eddimull/slide-distance-display/hardware/slidepod-schematic.pdf

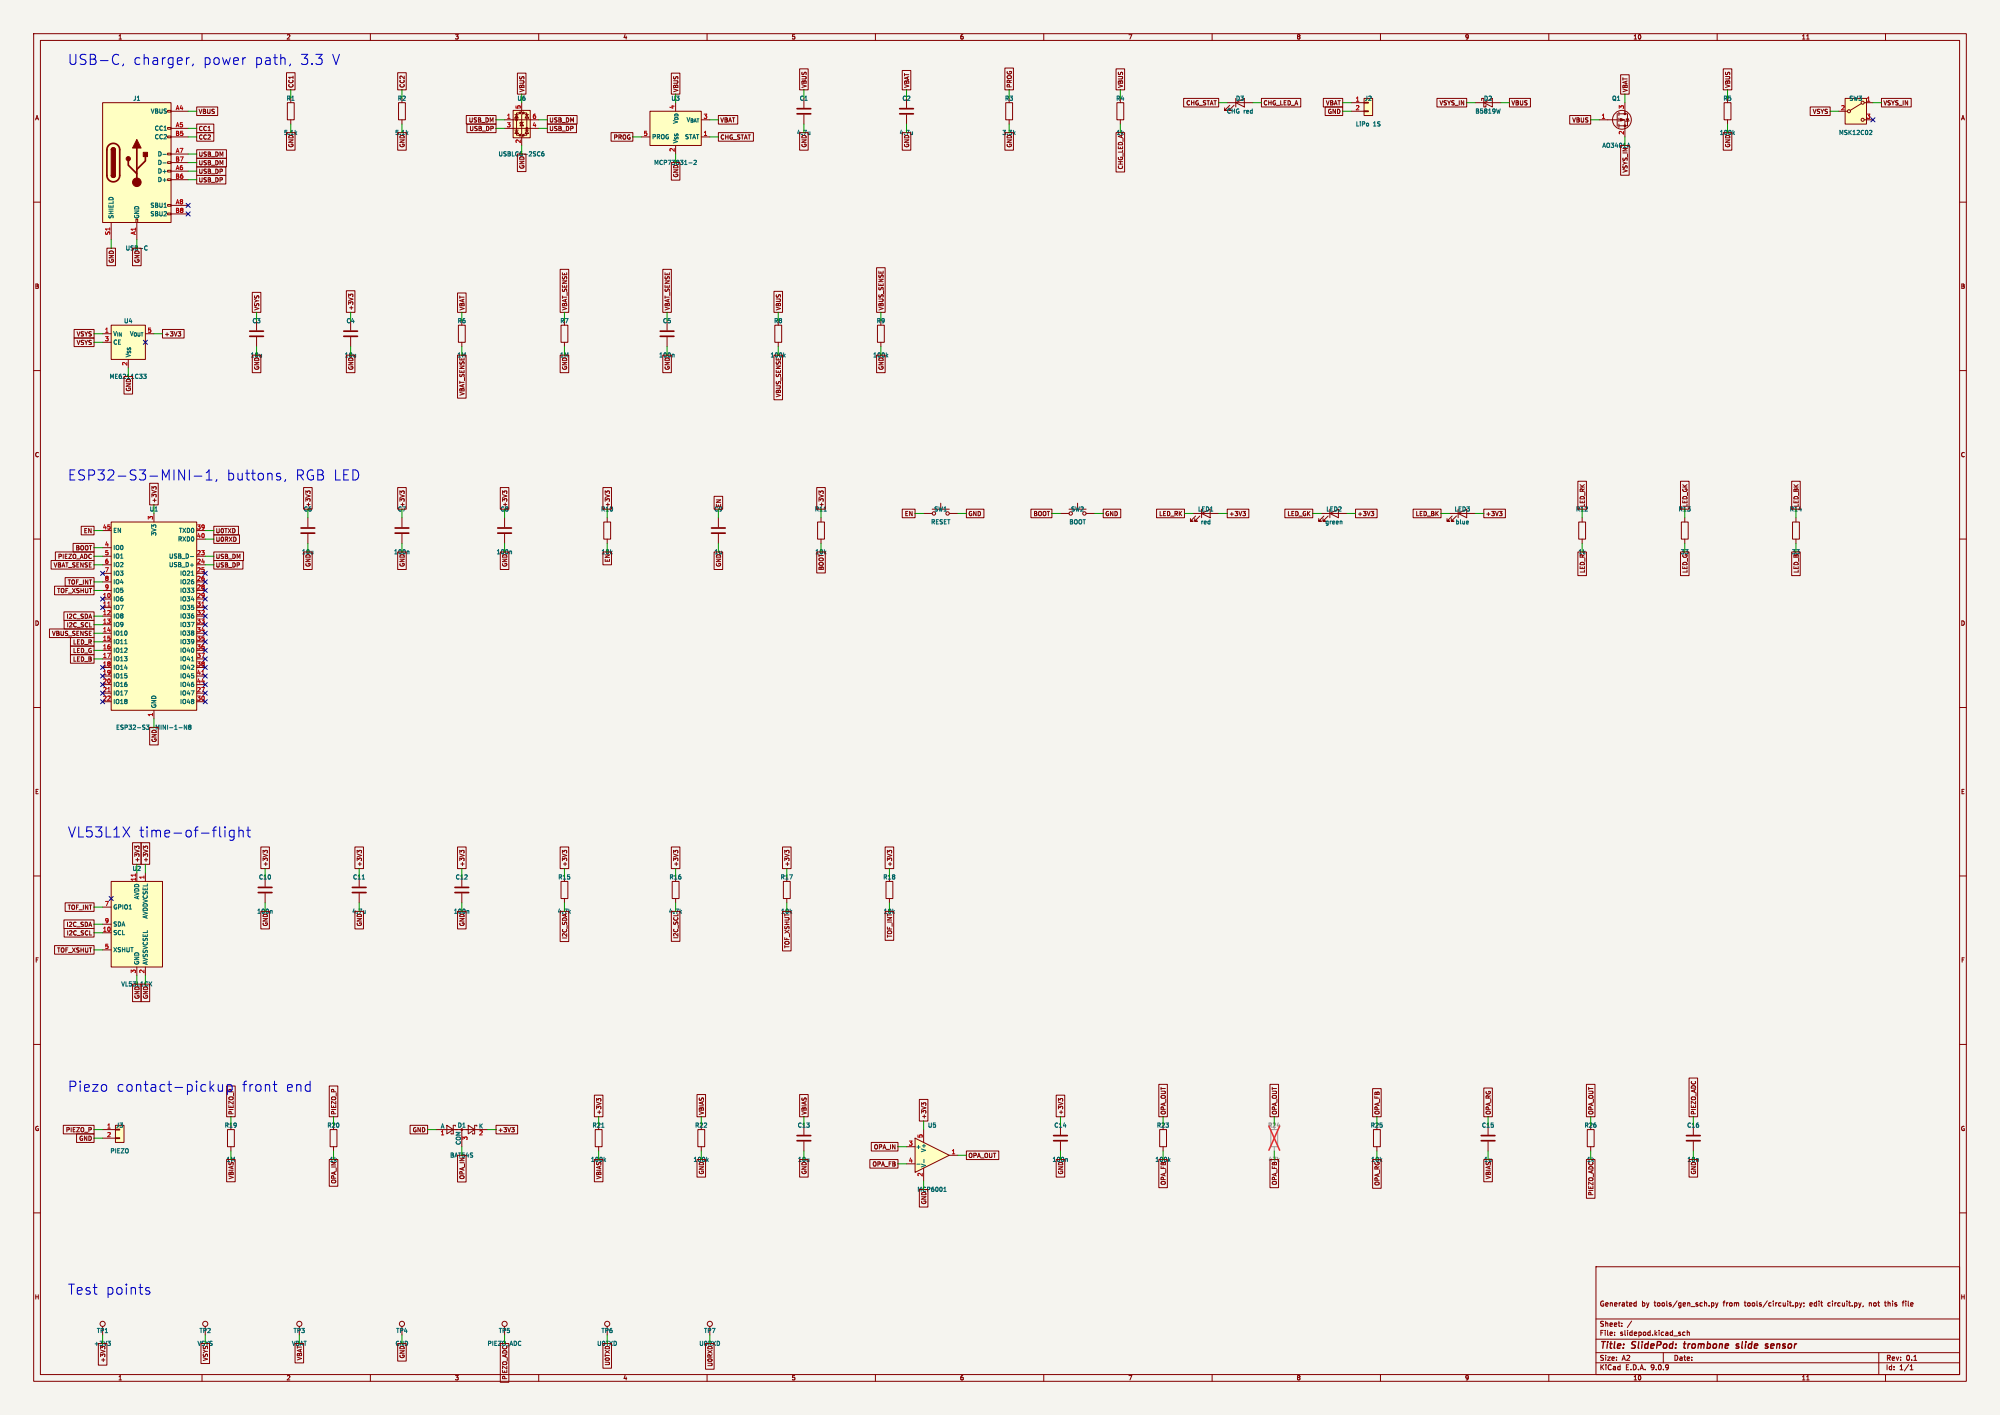
[picture p1: page 1]

USB-C, charger, power path, 3.3 V
