eddimull/slide-distance-display/hardware/slidepod.kicad_pcb

## KiCad design hardware/slidepod.kicad_pcb (2026-11-07)

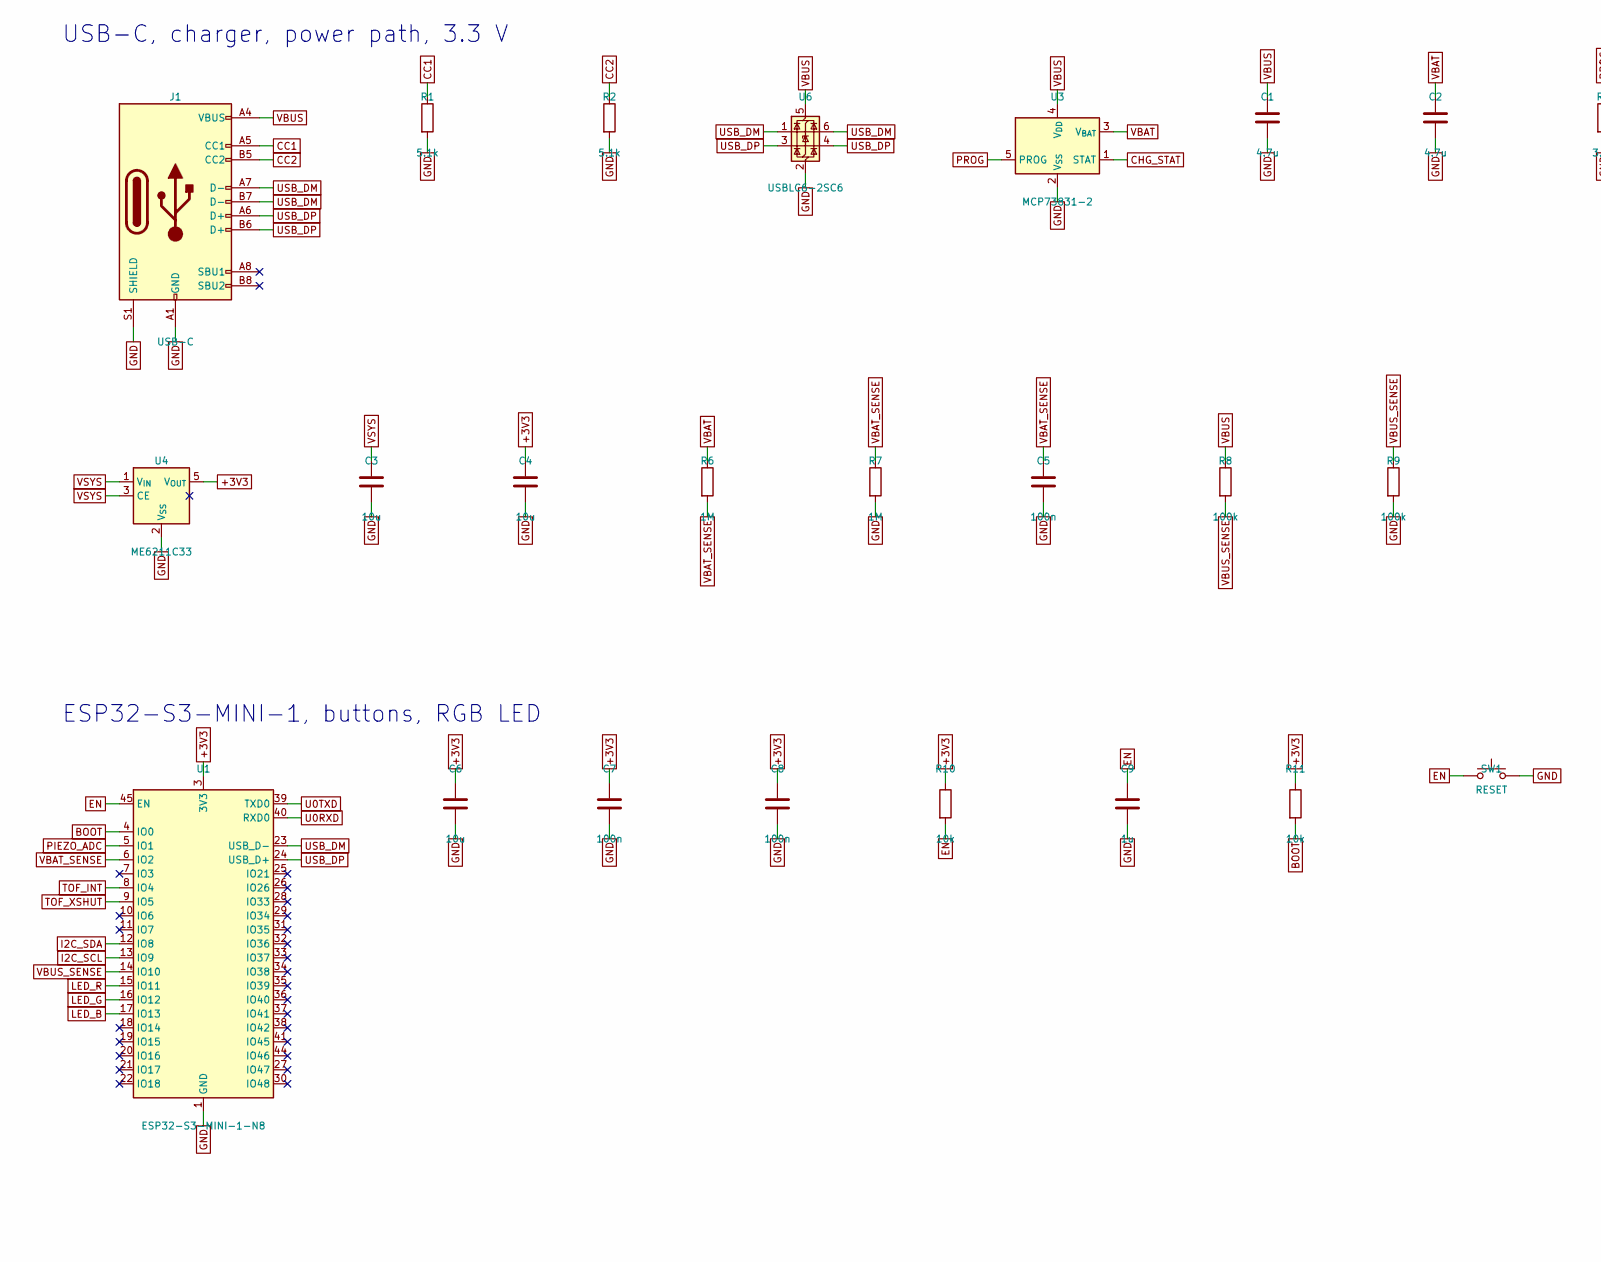
[picture p2: schematic slidepod.kicad_sch, SlidePod: trombone slide sensor, part in row 1, column 1]

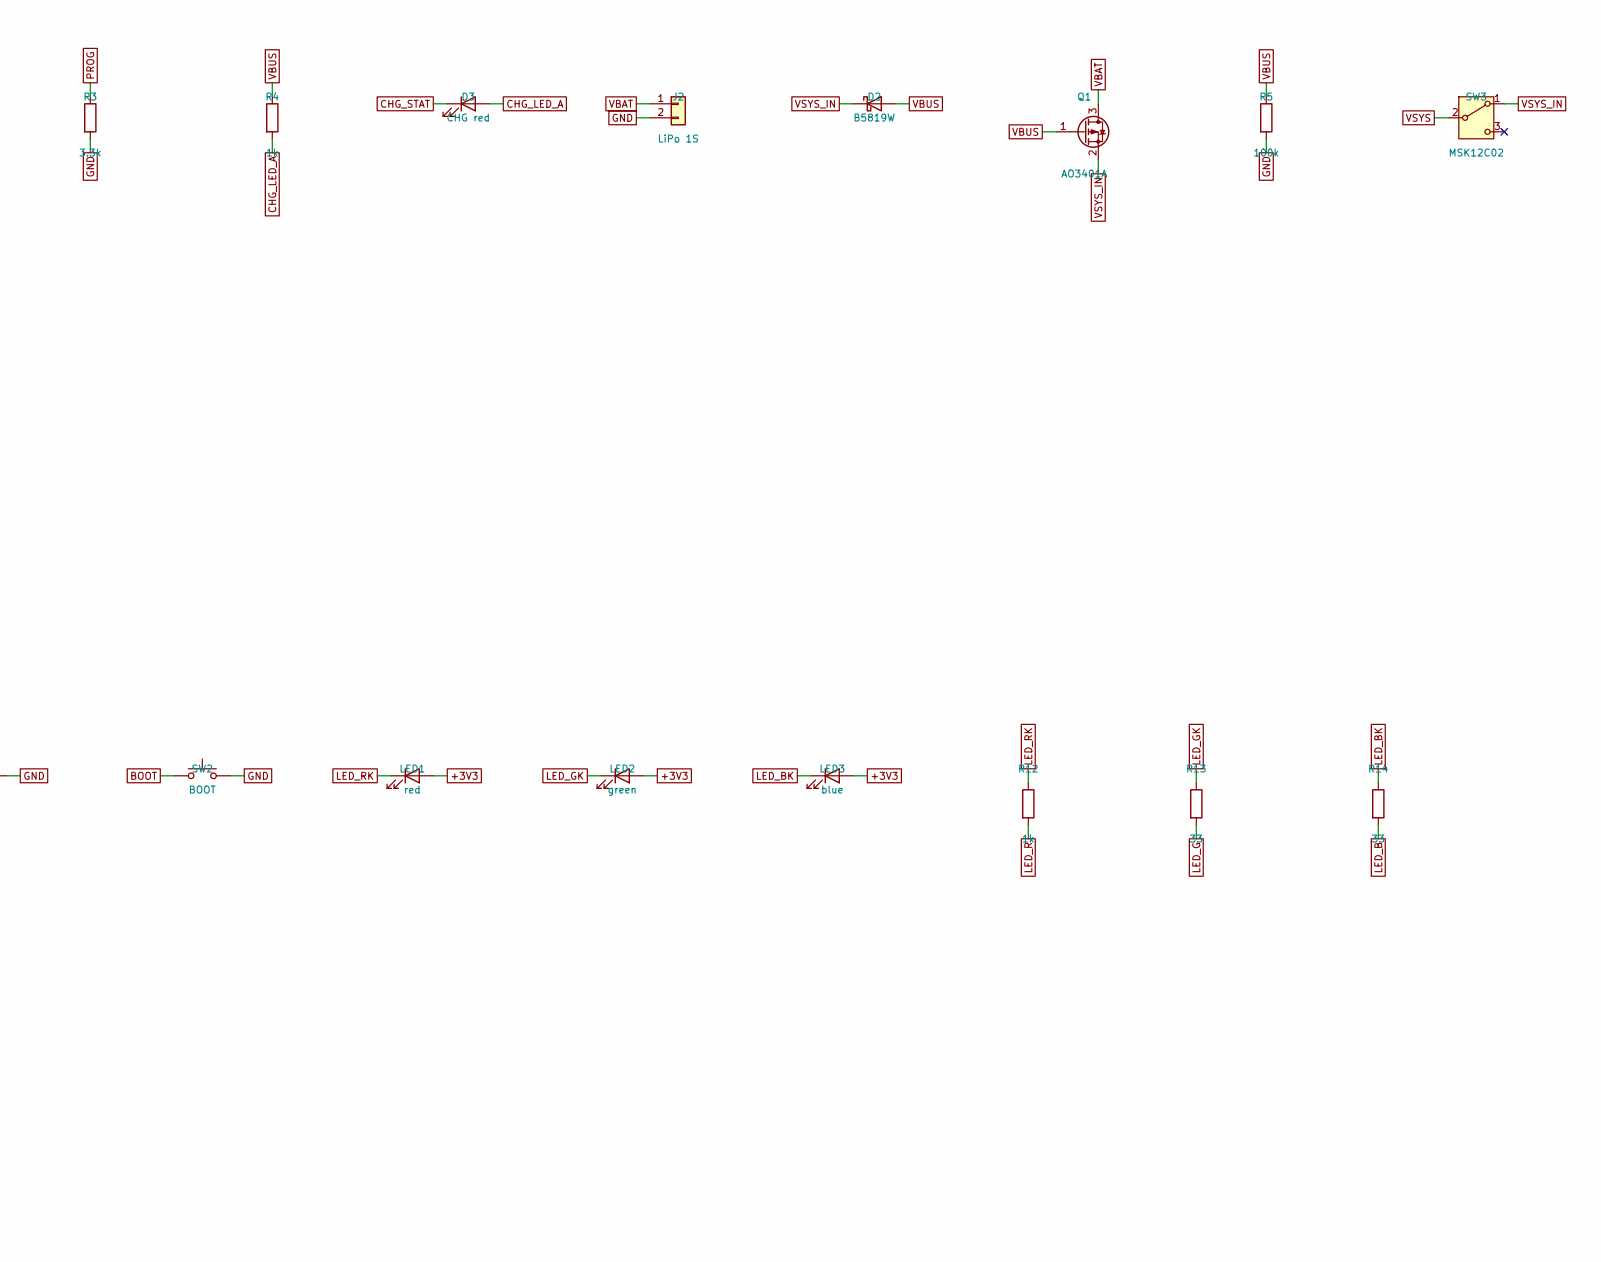
[picture p3: schematic slidepod.kicad_sch, SlidePod: trombone slide sensor, part in row 1, column 2]

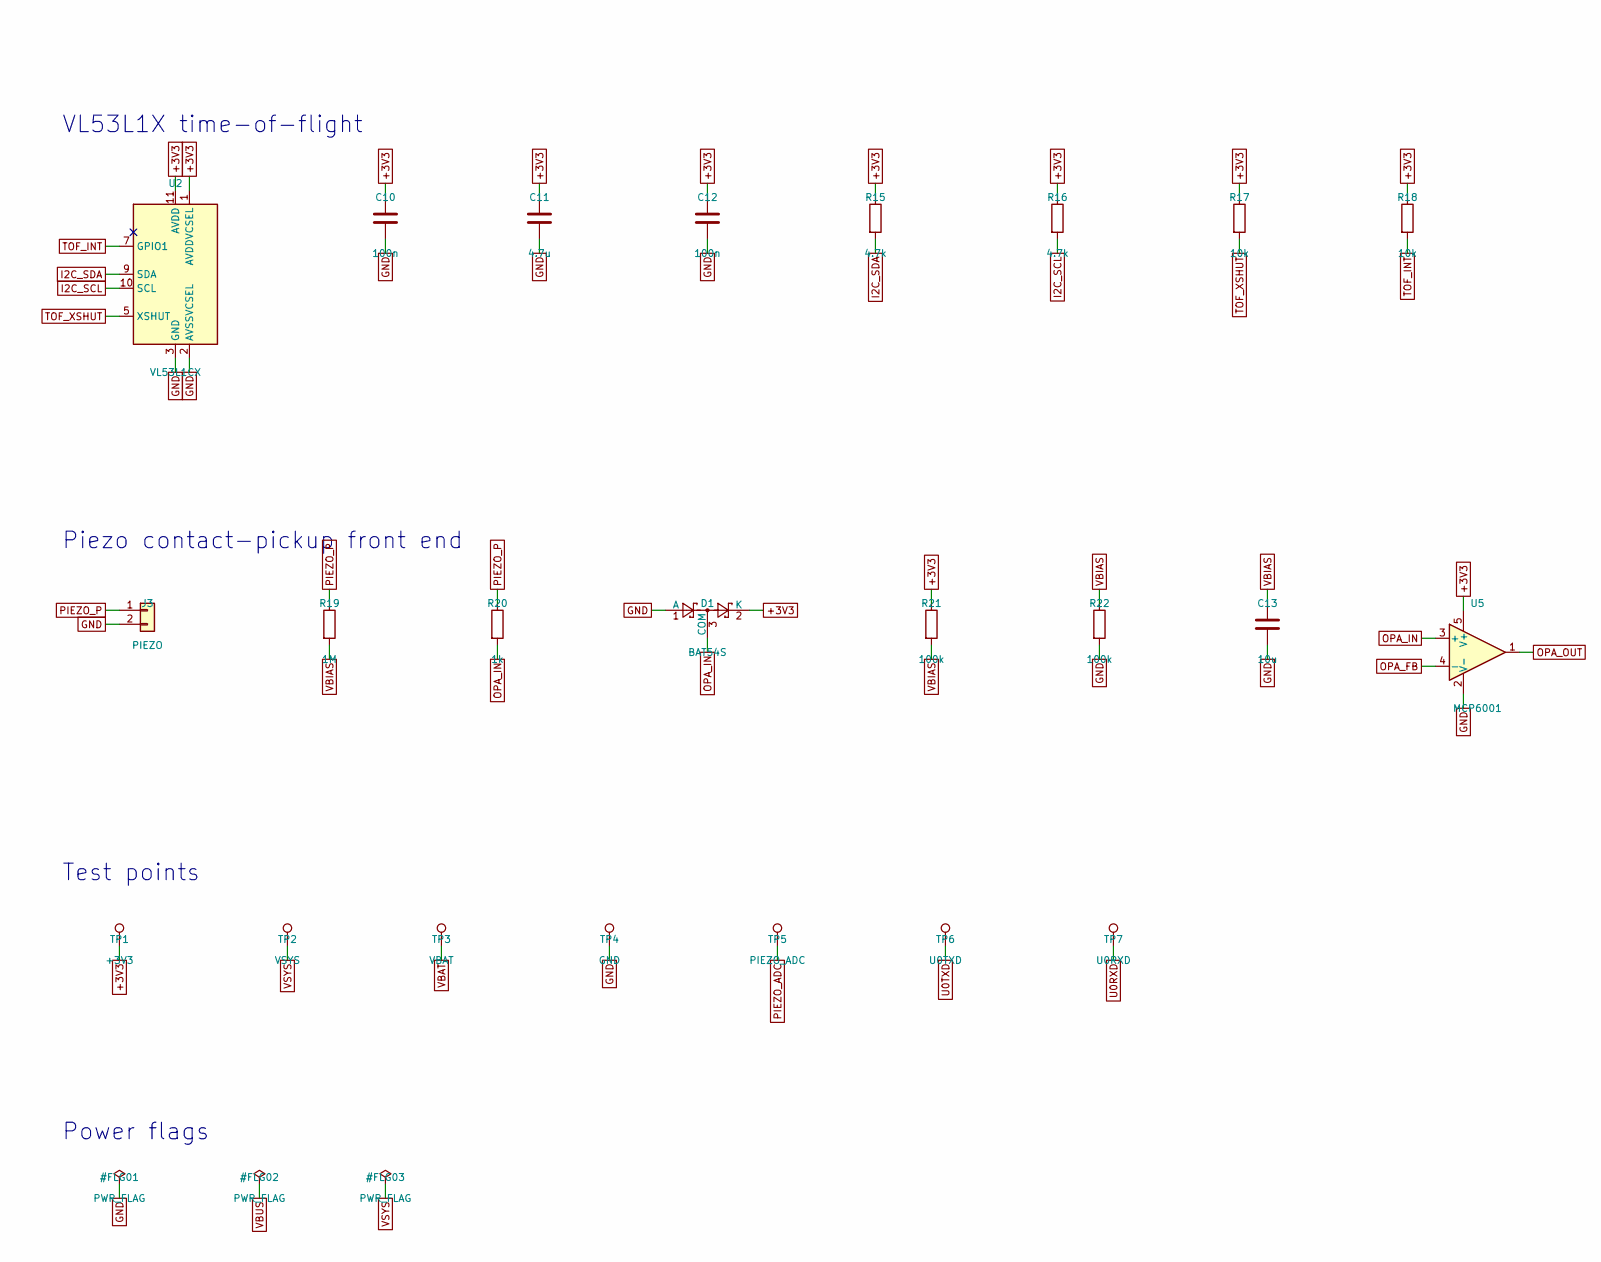
[picture p4: schematic slidepod.kicad_sch, SlidePod: trombone slide sensor, part in row 2, column 1]

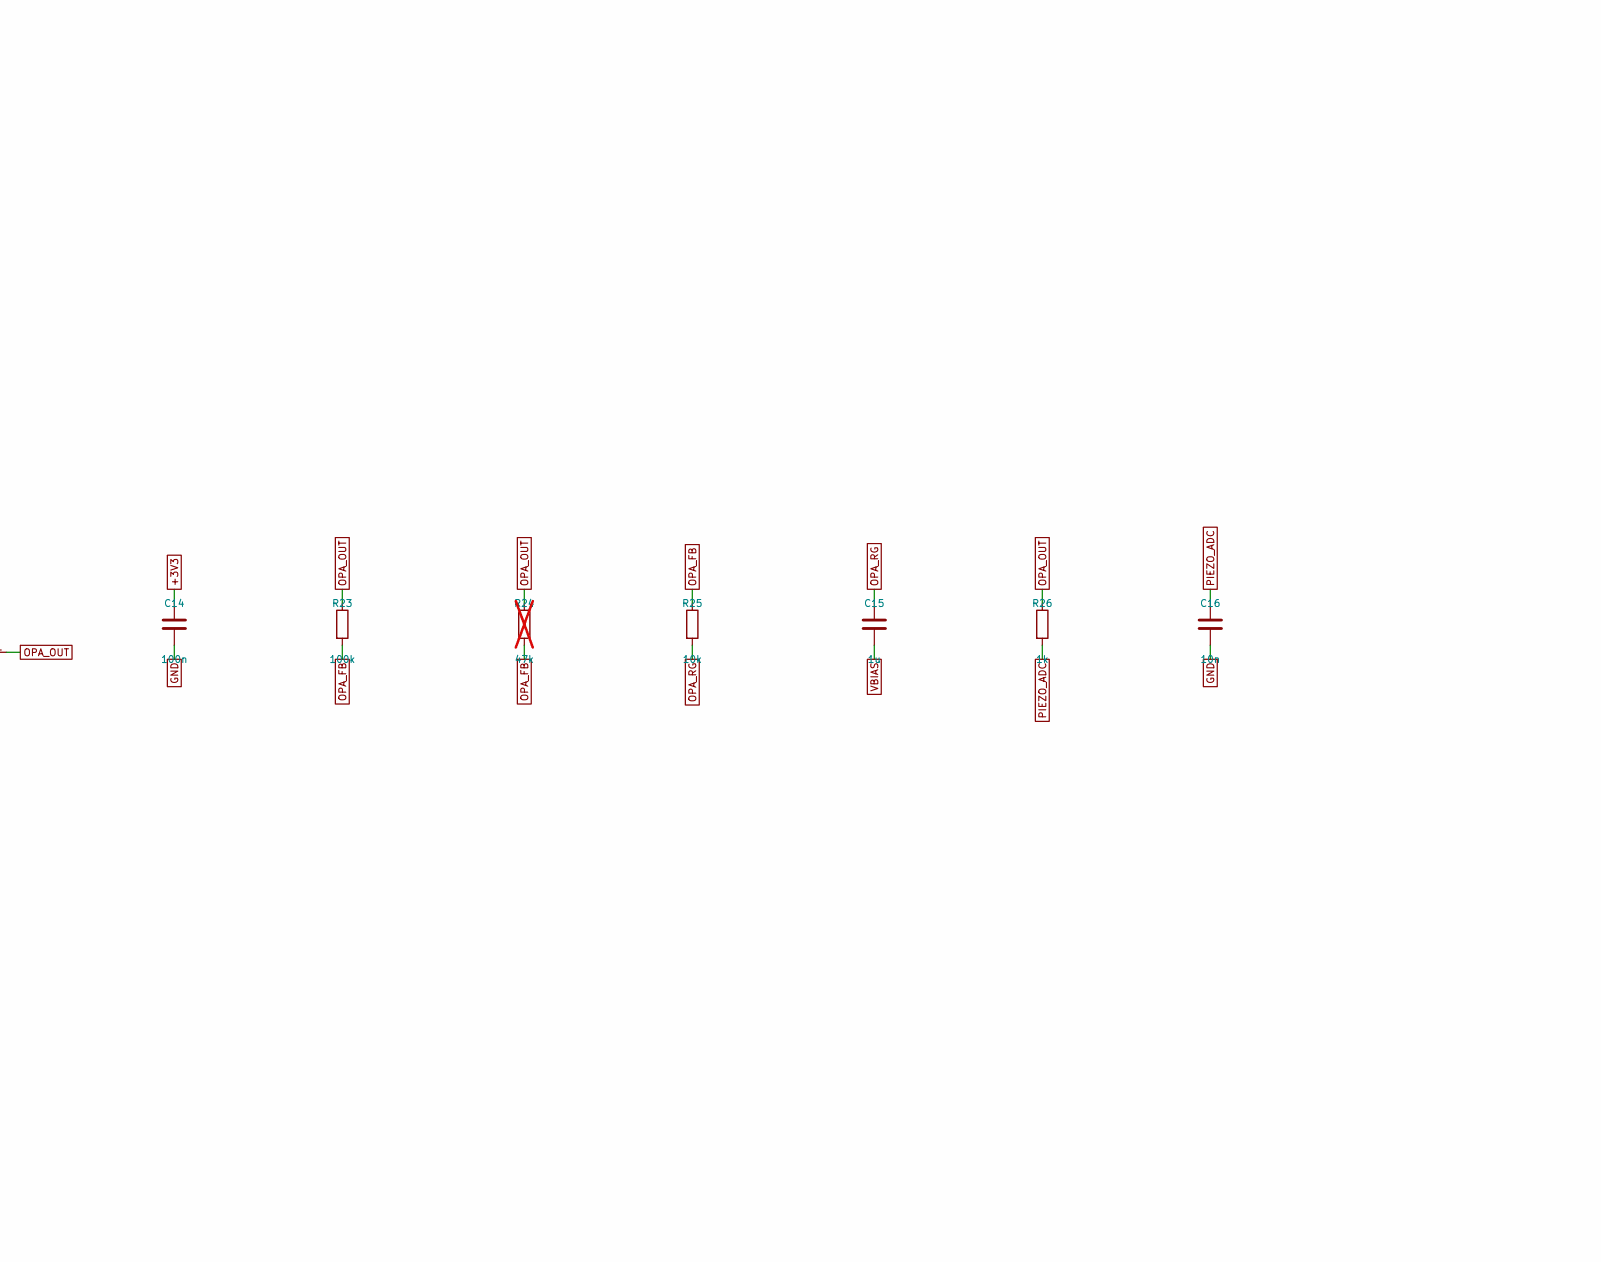
[picture p5: schematic slidepod.kicad_sch, SlidePod: trombone slide sensor, part in row 2, column 2]

Parts:
C1, C2, C11: 4.7u; C_0603_1608Metric; LCSC C19666
C3, C4, C6, C13: 10u; C_0603_1608Metric; LCSC C19702
C5, C7, C8, C10, C12, C14: 100n; C_0402_1005Metric; LCSC C1525
C9, C15: 1u; C_0402_1005Metric; LCSC C52923
C16: 10n; C_0402_1005Metric; LCSC C15195
D1: BAT54S; SOT-23; LCSC C47546
D2: B5819W; D_SOD-123; LCSC C8598
D3: CHG red; LED_0603_1608Metric; LCSC C2286
J1: USB-C; USB_C_Receptacle_HRO_TYPE-C-31-M-12; LCSC C165948
J2: LiPo 1S; JST_PH_S2B-PH-SM4-TB_1x02-1MP_P2.00mm_Horizontal; LCSC C295747
J3: PIEZO; SolderWire-0.1sqmm_1x02_P3.6mm_D0.4mm_OD1mm
LED1: red; LED_0603_1608Metric; LCSC C2286
LED2: green; LED_0603_1608Metric; LCSC C12624
LED3: blue; LED_0603_1608Metric; LCSC C2288
Q1: AO3401A; SOT-23; LCSC C15127
R1, R2: 5.1k; R_0402_1005Metric; LCSC C25905
R3: 3.3k; R_0402_1005Metric; LCSC C25890
R4, R12, R20, R26: 1k; R_0402_1005Metric; LCSC C11702
R5, R8, R9, R21, R22, R23: 100k; R_0402_1005Metric; LCSC C25741
R6, R7, R19: 1M; R_0402_1005Metric; LCSC C26083
R10, R11, R17, R18, R25: 10k; R_0402_1005Metric; LCSC C25744
R13, R14: 33; R_0402_1005Metric; LCSC C25105
R15, R16: 4.7k; R_0402_1005Metric; LCSC C25900
R24: 47k; R_0402_1005Metric; LCSC C25792; not fitted
SW1: RESET; SW_Push_1P1T_XKB_TS-1187A; LCSC C318884
SW2: BOOT; SW_Push_1P1T_XKB_TS-1187A; LCSC C318884
SW3: MSK12C02; SW_SPDT_Shouhan_MSK12C02; LCSC C431540
TP1: +3V3; TestPoint_Pad_D1.0mm
TP2: VSYS; TestPoint_Pad_D1.0mm
TP3: VBAT; TestPoint_Pad_D1.0mm
TP4: GND; TestPoint_Pad_D1.0mm
TP5: PIEZO_ADC; TestPoint_Pad_D1.0mm
TP6: U0TXD; TestPoint_Pad_D1.0mm
TP7: U0RXD; TestPoint_Pad_D1.0mm
U1: ESP32-S3-MINI-1-N8; ESP32-S2-MINI-1; LCSC C2913206
U2: VL53L1CX; ST_VL53L1x; LCSC C190004
U3: MCP73831-2; SOT-23-5; LCSC C424093
U4: ME6211C33; SOT-23-5; LCSC C82942
U5: MCP6001; SOT-23-5; LCSC C116490
U6: USBLC6-2SC6; SOT-23-6; LCSC C7519

Connections:
+3V3: C4.1, C6.1, C7.1, C8.1, C10.1, C11.1, C12.1, C14.1, D1.2 (K), LED1.2 (A), LED2.2 (A), LED3.2 (A), R10.1, R11.1, R15.1, R16.1, R17.1, R18.1, R21.1, TP1.1, U1.3 (3V3), U2.1 (AVDDVCSEL), U2.11 (AVDD), U4.5 (V_{OUT}), U5.5 (V+)
BOOT: R11.2, SW2.1, U1.4 (IO0)
CC1: J1.A5 (CC1), R1.1
CC2: J1.B5 (CC2), R2.1
CHG_LED_A: D3.2 (A), R4.2
CHG_STAT: D3.1 (K), U3.1 (STAT)
EN: C9.1, R10.2, SW1.1, U1.45 (EN)
GND: C1.2, C2.2, C3.2, C4.2, C5.2, C6.2, C7.2, C8.2, C9.2, C10.2, C11.2, C12.2, C13.2, C14.2, C16.2, D1.1 (A), J1.A1 (GND), J1.A12 (GND), J1.B1 (GND), J1.B12 (GND), J1.S1 (SHIELD), J2.2, J3.2, R1.2, R2.2, R3.2, R5.2, R7.2, R9.2, R22.2, SW1.2, SW2.2, TP4.1, U1.1 (GND), U1.2 (GND), U1.42 (GND), U1.43 (GND), U1.46 (GND), U1.47 (GND), U1.48 (GND), U1.49 (GND), U1.50 (GND), U1.51 (GND), U1.52 (GND), U1.53 (GND), U1.54 (GND), U1.55 (GND), U1.56 (GND), U1.57 (GND), U1.58 (GND), U1.59 (GND), U1.60 (GND), U1.61 (GND), U1.62 (GND), U1.63 (GND), U1.64 (GND), U1.65 (GND), U2.2 (AVSSVCSEL), U2.3 (GND), U2.4 (GND), U2.6 (GND), U2.12 (GND), U3.2 (V_{SS}), U4.2 (V_{SS}), U5.2 (V-), U6.2 (GND)
I2C_SCL: R16.2, U1.13 (IO9), U2.10 (SCL)
I2C_SDA: R15.2, U1.12 (IO8), U2.9 (SDA)
LED_B: R14.2, U1.17 (IO13)
LED_BK: LED3.1 (K), R14.1
LED_G: R13.2, U1.16 (IO12)
LED_GK: LED2.1 (K), R13.1
LED_R: R12.2, U1.15 (IO11)
LED_RK: LED1.1 (K), R12.1
OPA_FB: R23.2, R24.2, R25.1, U5.4 (-)
OPA_IN: D1.3 (COM), R20.2, U5.3 (+)
OPA_OUT: R23.1, R24.1, R26.1, U5.1
OPA_RG: C15.1, R25.2
PIEZO_ADC: C16.1, R26.2, TP5.1, U1.5 (IO1)
PIEZO_P: J3.1, R19.1, R20.1
PROG: R3.1, U3.5 (PROG)
TOF_INT: R18.2, U1.8 (IO4), U2.7 (GPIO1)
TOF_XSHUT: R17.2, U1.9 (IO5), U2.5 (XSHUT)
U0RXD: TP7.1, U1.40 (RXD0)
U0TXD: TP6.1, U1.39 (TXD0)
USB_DM: J1.A7 (D-), J1.B7 (D-), U1.23 (USB_D-), U6.1 (I/O1), U6.6 (I/O1)
USB_DP: J1.A6 (D+), J1.B6 (D+), U1.24 (USB_D+), U6.3 (I/O2), U6.4 (I/O2)
VBAT: C2.1, J2.1, Q1.3 (D), R6.1, TP3.1, U3.3 (V_{BAT})
VBAT_SENSE: C5.1, R6.2, R7.1, U1.6 (IO2)
VBIAS: C13.1, C15.2, R19.2, R21.2, R22.1
VBUS: C1.1, D2.2 (A), J1.A4 (VBUS), J1.A9 (VBUS), J1.B4 (VBUS), J1.B9 (VBUS), Q1.1 (G), R4.1, R5.1, R8.1, U3.4 (V_{DD}), U6.5 (VBUS)
VBUS_SENSE: R8.2, R9.1, U1.14 (IO10)
VSYS: C3.1, SW3.2 (B), TP2.1, U4.1 (V_{IN}), U4.3 (CE)
VSYS_IN: D2.1 (K), Q1.2 (S), SW3.1 (A)

Notes on the sheet:
USB-C, charger, power path, 3.3 V
ESP32-S3-MINI-1, buttons, RGB LED
VL53L1X time-of-flight
Piezo contact-pickup front end
Test points
Power flags

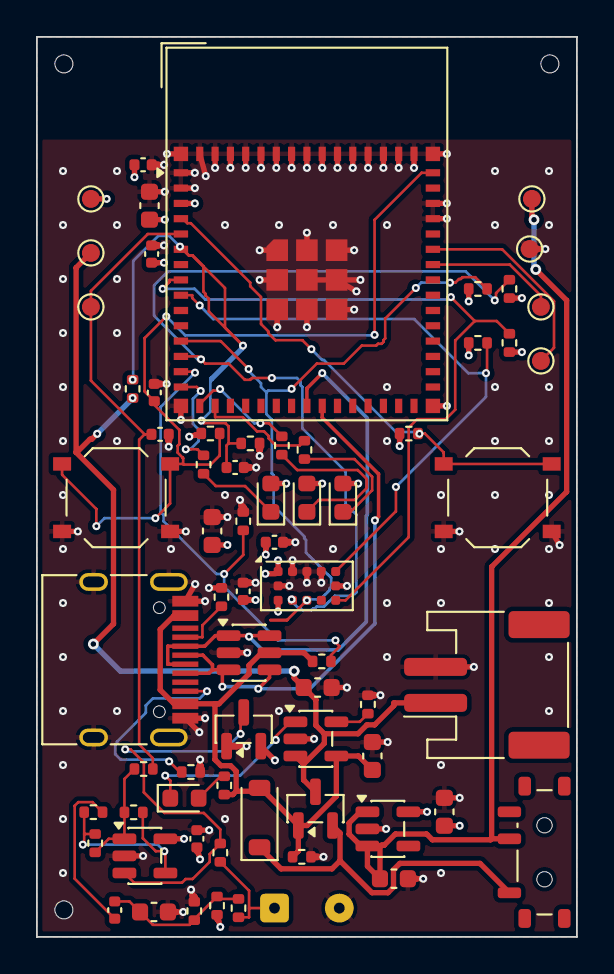
[picture p6: board slidepod.kicad_pcb from above]

Board: 4 copper layers, 30.0 x 50.0 mm, 71 parts (0 on the bottom side), 36 nets.

Other parts of the board:
TH1, TH2, TH3: (no value)
