eddimull/slide-distance-display/(commit log)

2024-03-17 went with my own ultrasonic class
2024-03-24 added error message on startup
    [color_rectangle_sprite.h, em_vl.h, moving_average_filter.h, tft.ino]
2024-05-25 brought in a kalman filter and got the color sprite to work with it
2024-05-27 fixed the velocity cal
    [color_rectangle_sprite.h]
2024-05-27 added a fill screen to prevent any extra noise
    [color_rectangle_sprite.h, tft.ino]
2026-11-07 Add SlidePod rev 0.1 hardware: screenless BLE slide-sensor PCB
    Custom 30x50 mm 4-layer board, assembled by JLCPCB, to replace the LilyGo/TFT prototype:
    ESP32-S3-MINI-1, VL53L1X time-of-flight sensor for slide position, MCP6001 piezo
    contact-pickup amplifier for pitch, USB-C LiPo charging with a power path, and status
    LEDs. Output goes over BLE to the Flutter app.
    The design is generated from Python (tools/circuit.py is the source of truth): the
    schematic, the PCB placement, a staged routing pipeline (plane fan-out, Freerouting,
    an A* finishing router, GND stitching) and the JLC fab outputs. It runs in the
    kicad/kicad:9.0 Docker image via the Makefile.
    ERC is clean, the netlist matches circ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
2026-11-07 hardware: LCSC numbers for the green and blue status LEDs
    LED2 = KENTO KT-0603G (C12624), LED3 = KENTO KT-0603B (C2288). JLC has no Basic green or
    blue 0603 LED, so both are Extended. Every BOM line now has an LCSC part. Fab outputs,
    schematic and PDF regenerated; the Gerbers differ only in timestamps.
    Claude-Session: https://claude.ai/code/session_01NxEkNn9qr2vgR67pQkN4CP
2026-11-07 hardware: add JLCPCB tooling holes and ordering instructions
    - gen_pcb.py: add 3 × 1.0 mm NPTH tooling holes at board corners for pick-and-place
    - add_tooling_holes.py: one-shot script to patch the holes into an existing routed PCB
    - slidepod.kicad_pcb: tooling holes applied directly (routing preserved)
    - fab/: regenerated Gerbers, BOM, CPL, zip with tooling holes in NPTH drill file
    - fab/JLCPCB_ORDER.md: step-by-step ordering instructions for the Chrome agent
2026-11-07 added mount holes
2026-11-07 hardware: fold first-order JLCPCB corrections into fab tooling
    export_jlc.py:
    - Group BOM by LCSC part number so D3+LED1 (C2286) and SW1+SW2 (C318884)
    appear on one line each, avoiding JLCPCB's "multiple lines matched" warning
    - Add LCSC_ROT_OFFSET table: 7 parts needed rotation correction vs. JLCPCB
    part models (SOT-23/5/6 and LGA-12 packages)
    - Add CPL_XY_OFFSET table: U1 shifted 2.5 mm toward board centre, J1 shifted
    1.1 mm into the board to align signal pins with pads
    JLCPCB_ORDER.md:
    - PCBA Type must be Standard (not Economic) — ESP32-S3 and VL53L1CX require it
    - Actual cost reference: $161.86 for 5 assembled boards before shipping
    - Rotation and position correction tables now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
2026-11-07 sim: add LTspice piezo simulation and Wokwi scaffold for SlidePod firmware
    sim/ltspice/slidepod-piezo.cir:
    - Full SPICE netlist: MCP6001, BAT54S clamp, bias divider, AA filter
    - .ac sweep (1 Hz – 200 kHz) + .tran (10 ms) analyses ready to run
    - Expected: 20.8 dB gain, -3 dB at ~35 Hz and ~15.9 kHz
    sim/wokwi/diagram.json + wokwi.toml:
    - ESP32-S3-DevKitC-1 + wokwi-vl53l0x (VL53L1X proxy) + RGB LEDs + BOOT button
    - Points wokwi.toml at the slidepod-sim PlatformIO build output
    src/slidepod/main.cpp:
    - Firmware skeleton: VL53L sensor read at 50 Hz, Kalman filter, LED status
    - #ifdef WOKWI_SIM switches between VL53L0X (Wokwi) and VL53L1X (hardware)
    - Serial CSV output mirrors the BLE GATT payl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
2026-11-08 sim: mock ToF in Wokwi, add wokwi-cli MCP server
    Wokwi ESP32 I2C simulation is non-functional (bus scan finds zero
    devices on both CLI and VS Code extension), so replace the VL53L0X
    I2C sensor with a mock triangle-wave generator for the sim build.
    - Mock ToF sweeps 50–550 mm at 2 mm/tick; BOOT button toggles sweep
    - Switch sim board to plain ESP32 (esp32dev) for working serial
    - Split pin assignments with #ifdef WOKWI_SIM (GPIO 25/26/27 LEDs)
    - Remove VL53L0X lib_dep from slidepod-sim (no I2C needed)
    - Add wokwi-cli MCP server config and VS Code extension recommendation
    - Simplify diagram.json to LEDs + BOOT button only
2026-11-08 fix: prevent false BOOT button trigger on Wokwi startup
    GPIO0 reads LOW on the first loop iteration before the internal
    pull-up stabilizes, which falsely triggered the falling-edge
    detector and disabled the mock ToF sweep. Initialize prev_btn
    to LOW so the first read is never seen as a button press.
2026-11-08 feat: add BLE GATT position notify via NimBLE
    Advertises as "SlidePod" with a custom GATT service. The position
    characteristic notifies a 6-byte payload (raw_mm, filt_mm, position
    scaled 0–10000) at 50 Hz when a central subscribes. Auto re-advertises
    on disconnect. BLE is gated out of the Wokwi sim build.
2026-11-08 feat: add Flutter companion app with BLE slide position display
    Scan and connect to SlidePod over BLE, subscribe to position
    notifications, and display the trombone slide position (1–7) in
    real time. Shows a progress bar, position markers, and raw sensor
    data. Uses flutter_blue_plus for cross-platform BLE.
2026-11-08 feat: add mock data source for debug builds
    In debug mode the app auto-starts with a triangle wave sweep
    (50–550 mm at 50 Hz) so the UI can be exercised without hardware.
    A BLE/Mock toggle lets you switch to real BLE when a SlidePod is
    available. Extracts a SlidePodSource interface shared by both.
2026-11-08 fix: exclude idle time from average speed calculation
    Only accumulate distance and elapsed time for the average when
    smoothed velocity exceeds 0.5 pos/s, so near-stationary periods
    don't drag the average down.
